basbaccarne/AirMaze/tests/img/fan_pinout.png

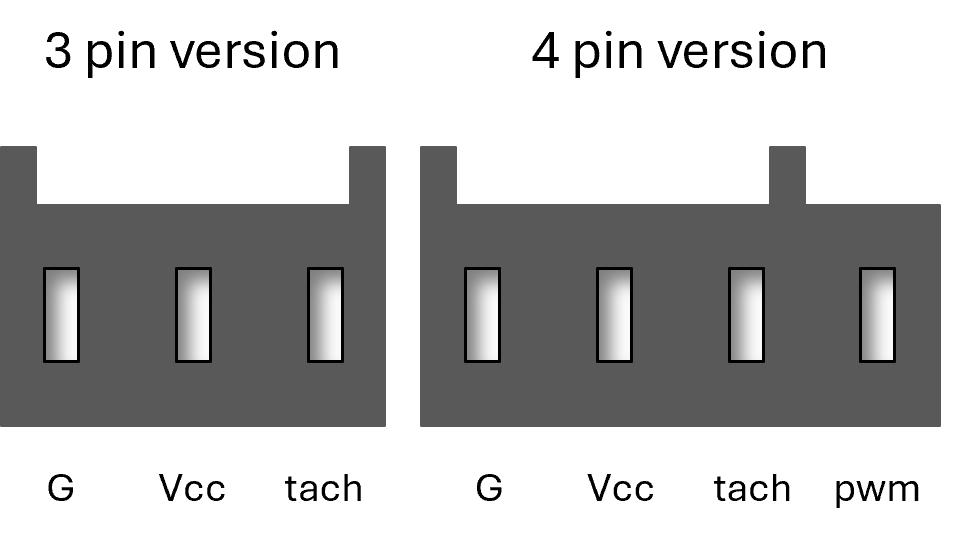
tests/img/fan_pinout.png
