basbaccarne/AirMaze/(commit log)

2024-05-02 Add MOSFET fan switching test code
2024-05-02 Update MOSFET fan switching.ino
